hgh-29/Smart-Plant-Monitor/README.md

[README.pdf](https://github.com/user-attachments/files/24240184/README.pdf)
