hgh-29/Smart-Plant-Monitor/Presentations/Smart Plant Monitor Proof-of-Concept Prototype (1).pdf

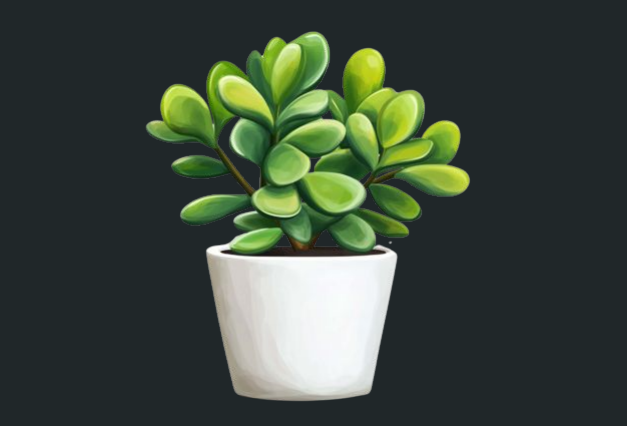
[picture p1: figure]

# Smart Plant Monitor Proof-of-Concept Prototype

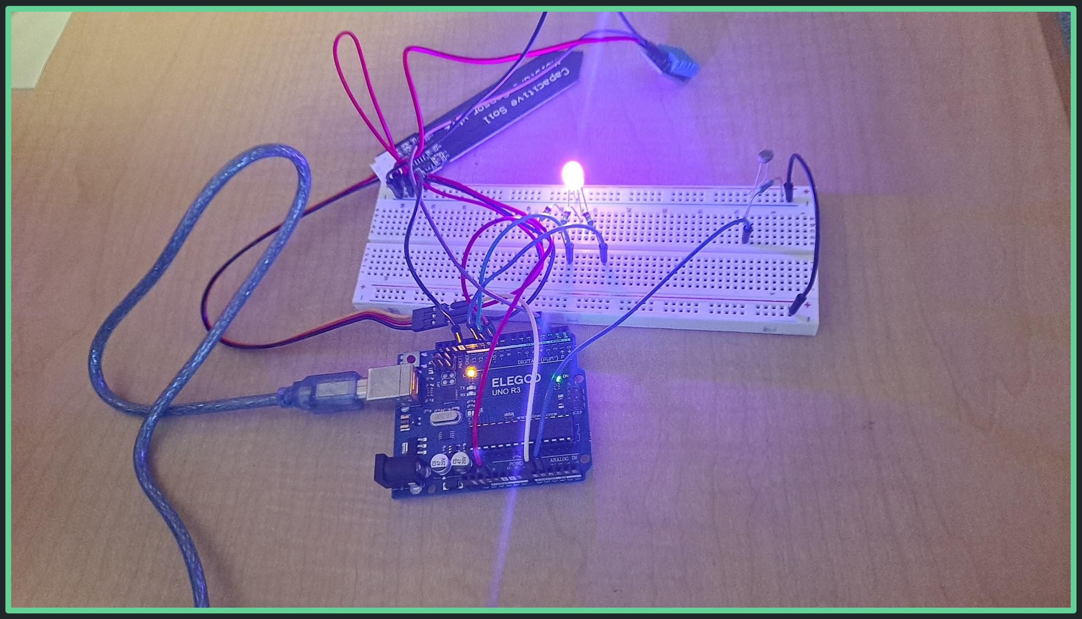
[picture p2: figure]

Rachel Romeo, Hailey Horvath, Adrian Szurlej ECET 230
10/21/2025

## The Smart Plant Monitor

What our project is supposed to do when complete

- The Smart Plant Monitor will be a simple, portable device that aims to monitor temperature, soil moisture and sunlight levels to keep plants healthy.
- The sensors will collect environmental data and give the user continuous feedback through the use of an RGB LED.
- The use of the project will make it easier to take care of plants.

## The Smart Plant Monitor

Proof-of-Concept Prototype:

- Our project is able to measure and read the current temperature, soil moisture level and light level.
- Working Components:
- Soil Moisture Sensor
- Photoresistor
- DHT11 Temperature Sensor
- RGB LED
- Serial Input (to set optimal ranges)

## The Smart Plant Monitor

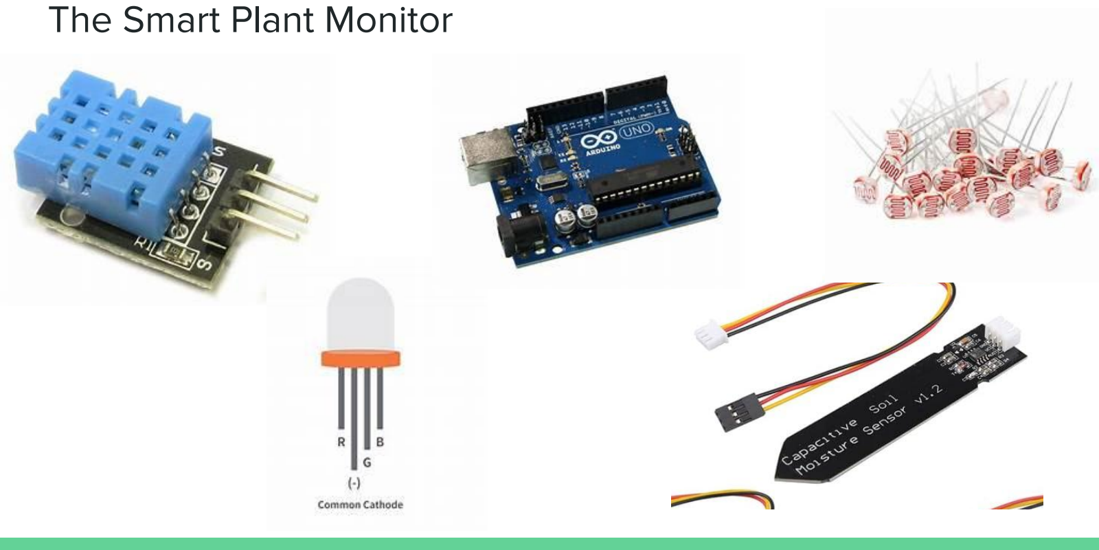
[picture p3: page 4]

## The Smart Plant Monitor

How it works:

- User is prompted to enter the optimal ranges for temperature and the minimum level for the soil moisture and light level
- Note: These are entered through the serial monitor since the input device isn’t set up yet

## The Smart Plant Monitor

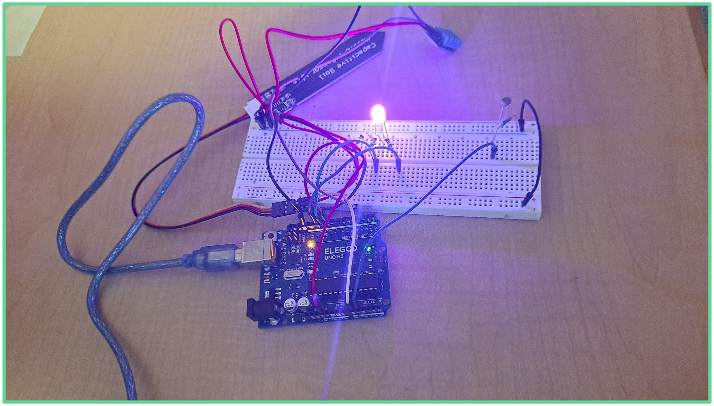
[picture p4: figure]

How it works:

- Sensors measures and reads the temperature, soil moisture and light level every 10 seconds.
- Note: 10 seconds can be changed to any duration of time
- Based on the user’s optimal ranges that were entered, the system determines whether or not if the current measurements fit into the ranges

## The Smart Plant Monitor

How it works:

Everything is in Optimal Range | RGB LED is off
Current Temperature is too hot | RGB LED turns red
Current Temperature is too cold | RGB LED turns blue
Current Soil Moisture is too dry | RGB LED turns yellow
Current Light Level is too dark | RGB LED turns purple

## The Smart Plant Monitor

How it works:

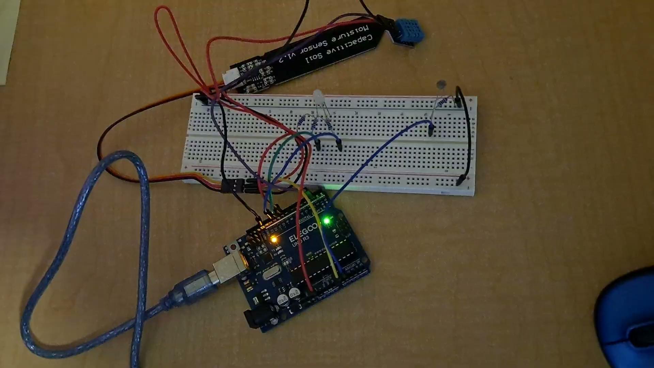
[picture p5: figure]

- If there is more than one measurement that is out of the optimal range, the RGB LED will instead blink in sequence.
- For example if the current temperature is too cold, the soil is too dry and it is too dark, the RGB LED will blink Blue, Yellow, Purple

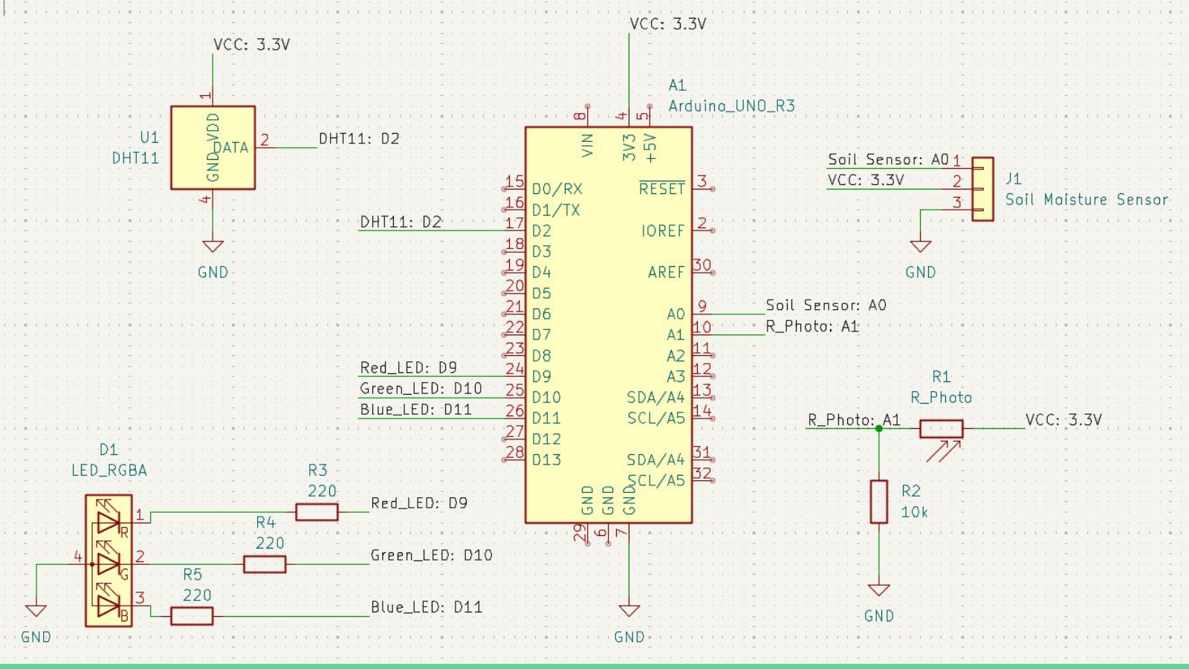
[picture p6: page 9]

## The Smart Plant Monitor

What still needs to be worked on:

- User Input Component
- Remote Control/IR Receiver
- Originally wanted to use rotary encoder
- Clock for Photoresistor
- To prevent the photoresistor from detecting low light during nighttime, a clock feature can be added to the code. This would allow the user to define specific night hours, ensuring the photoresistor is inactive during that period.
- Resistor Values
- To balance the brightness of the different colors in the RGB LED, each color should have a specific resistor value
- Display
- LCD1602
- Can be used to help guide the user when entering the optimal ranges
- Reset Button
- Used to reset the optimal ranges entered at the beginning

# Live Demo of the Proof-of-Concept Prototype

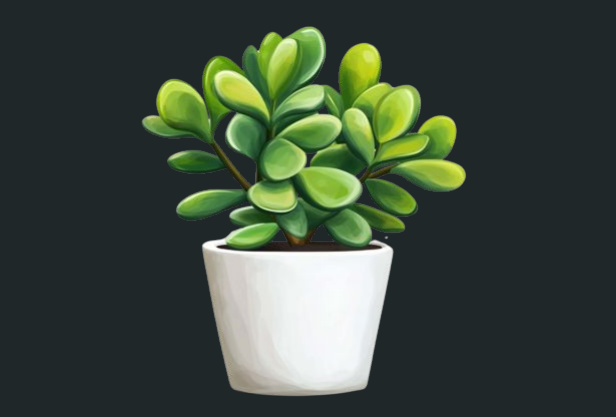
[picture p7: figure]

## Any Questions??
