hgh-29/Smart-Plant-Monitor/Presentations/Smart Plant Monitor_ ECET 230 Final Project.pdf

ECET 230-001
Professor Hansis

# Smart Plant

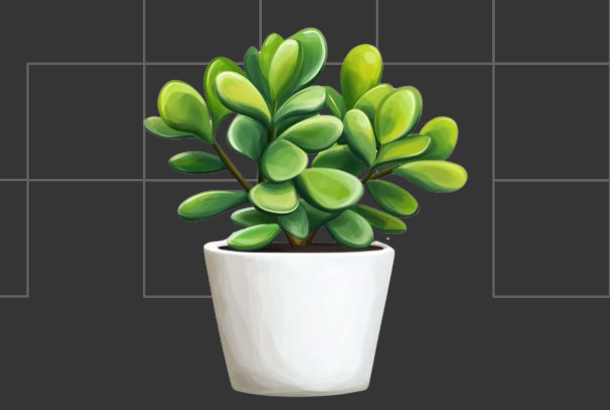
[picture p9: figure]

# Monitor

Rachel Romeo
Hailey Horvath
12/19/25

# Smart Plant Monitor Overview

# What is the Smart Plant Monitor? - The Smart Plant Monitor will be a simple, portable device that aims to monitor temperature, soil

moisture and sunlight levels to keep plants healthy.

# - The sensors will collect environmental data and

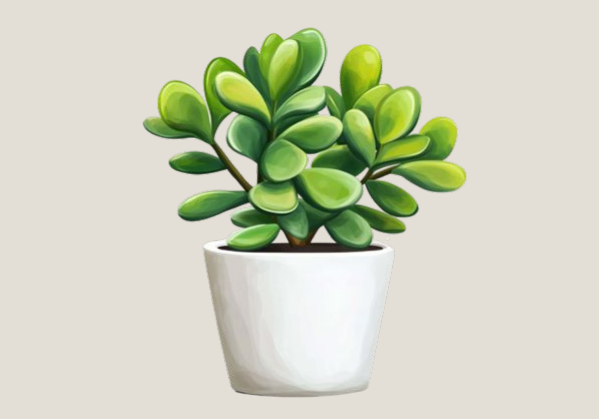
[picture p10: figure]

# give the user continuous feedback through the use

of an RGB LED.

# - The use of the project will make it easier to take

care of plants.

# Block Diagram

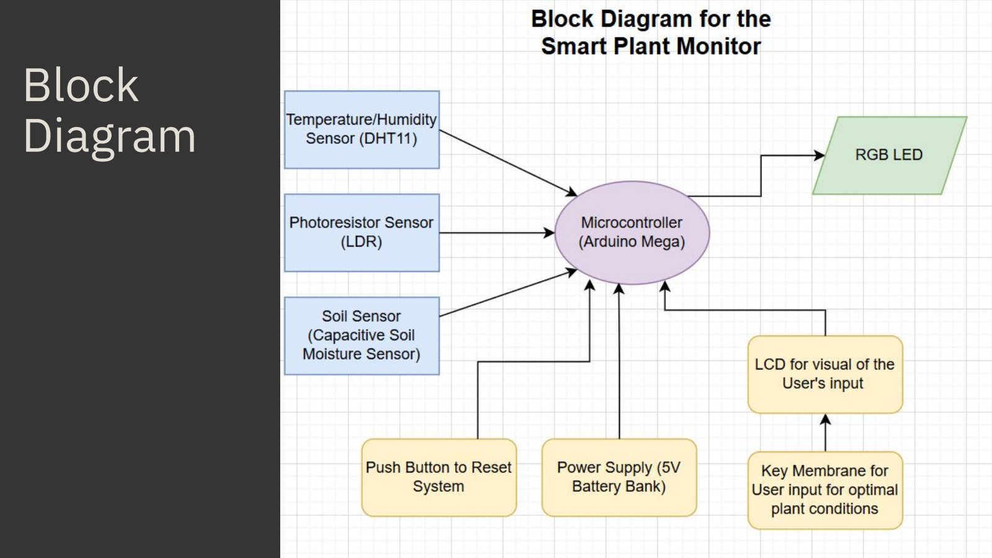
[picture p11: page 3]

# Development Process

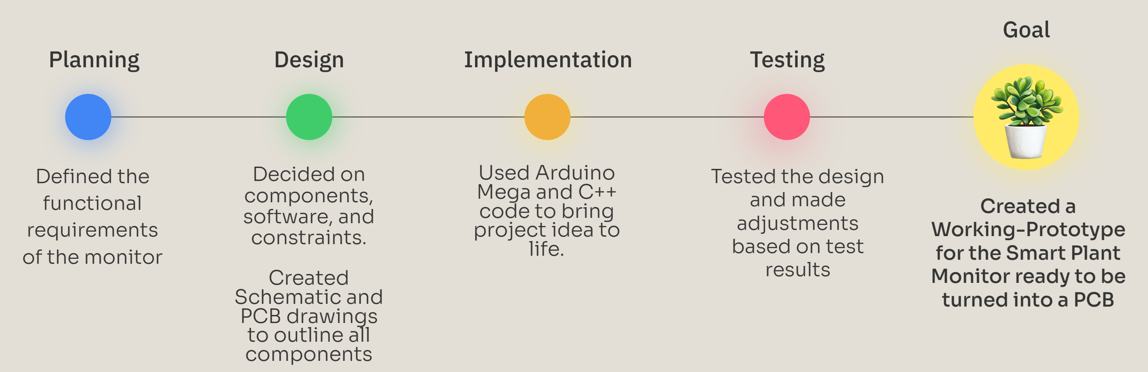
[picture p12: figure]
Planning; Design; Implementation; Testing; Goal; Defined the functional requirements of the monitor; Used Arduino Mega and C++ code to bring project idea to life.; Tested the design and made adjustments based on test results; Decided on components, software, and constraints.; Created Schematic and PCB drawings to outline all components; Created a Working-Prototype for the Smart Plant Monitor ready to be turned into a PCB

# Planning

# Key Functions:

# - Continuous Monitoring - Soil, Temperature, Sunlight - Plant Status Feedback - RGB LED - Low-Maintenance Operation - Battery Bank - Portable - Small, no larger than a phone

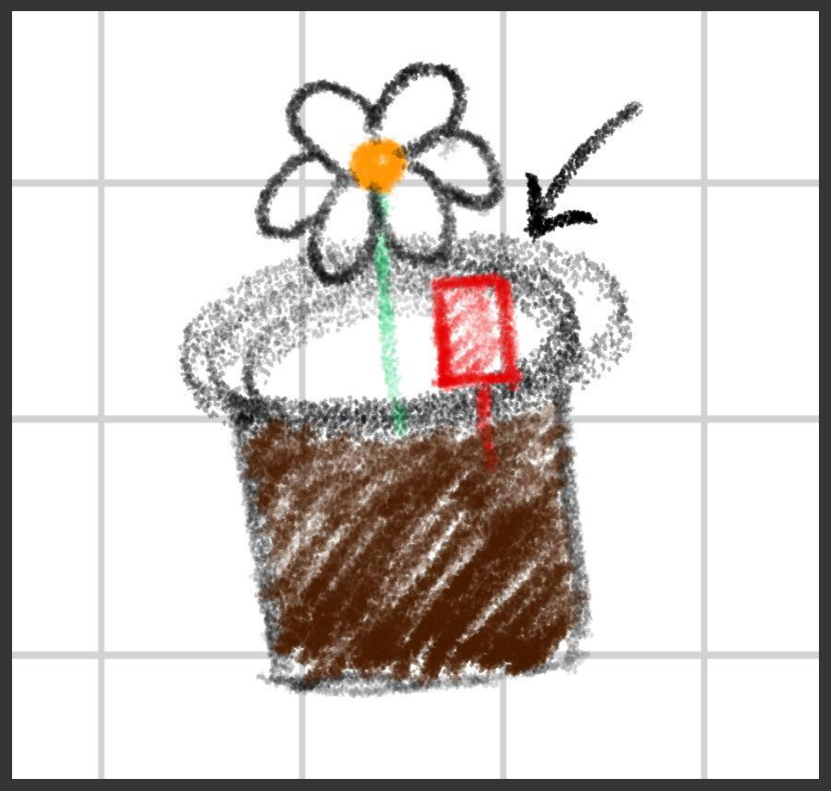
[picture p13: figure]

# Planning

Everything is in Optimal Range | RGB LED is off
Current Temperature is too hot | RGB LED turns red
Current Temperature is too cold | RGB LED turns blue
Current Soil Moisture is too dry | RGB LED turns yellow
Current Light Level is too dark | RGB LED turns purple

# - How the RGB LED works:

# Hardware Design

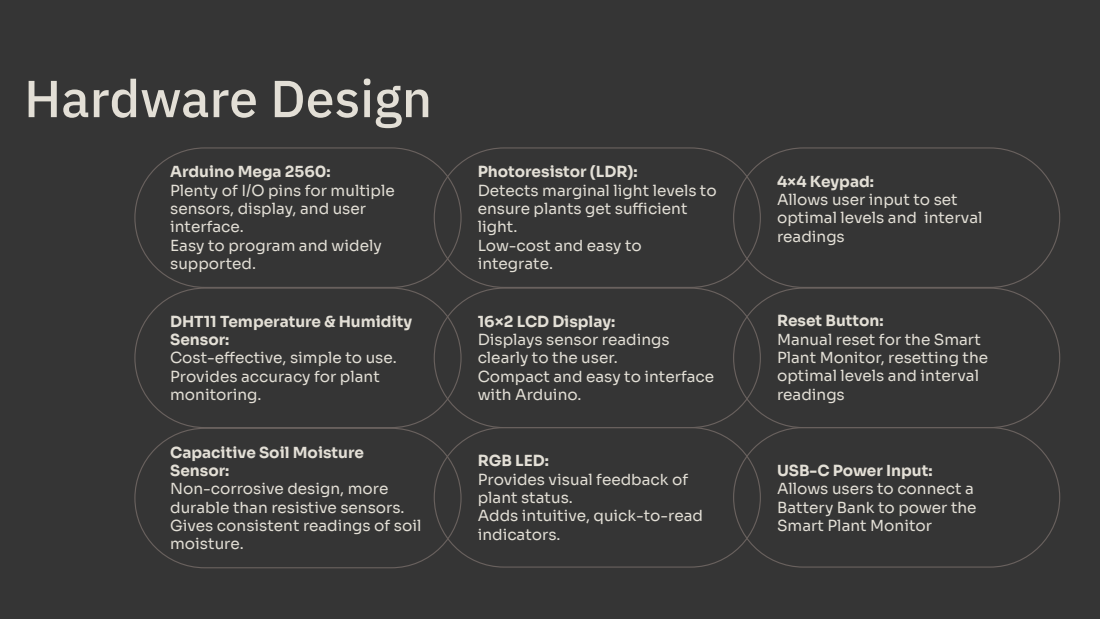
[picture p14: page 7]

Arduino Mega 2560:
Plenty of I/O pins for multiple
sensors, display, and user
interface.
Easy to program and widely
supported.

Photoresistor (LDR):
Detects marginal light levels to
ensure plants get sufficient
light.
Low-cost and easy to
integrate.

4×4 Keypad:
Allows user input to set
optimal levels and interval
readings

Reset Button:
Manual reset for the Smart
Plant Monitor, resetting the

DHT11 Temperature & Humidity
Sensor:
Cost-effective, simple to use.
Provides accuracy for plant
monitoring.

16×2 LCD Display:
Displays sensor readings
clearly to the user.
Compact and easy to interface
with Arduino.

Capacitive Soil Moisture
Non-corrosive design, more
durable than resistive sensors.
Gives consistent readings of soil
moisture.

RGB LED:
Provides visual feedback of
plant status.
Adds intuitive, quick-to-read
indicators.

USB-C Power Input:
Allows users to connect a
Battery Bank to power the
Smart Plant Monitor

# Hardware Design

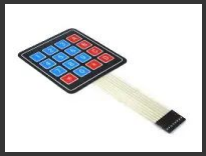
[picture p15: figure]
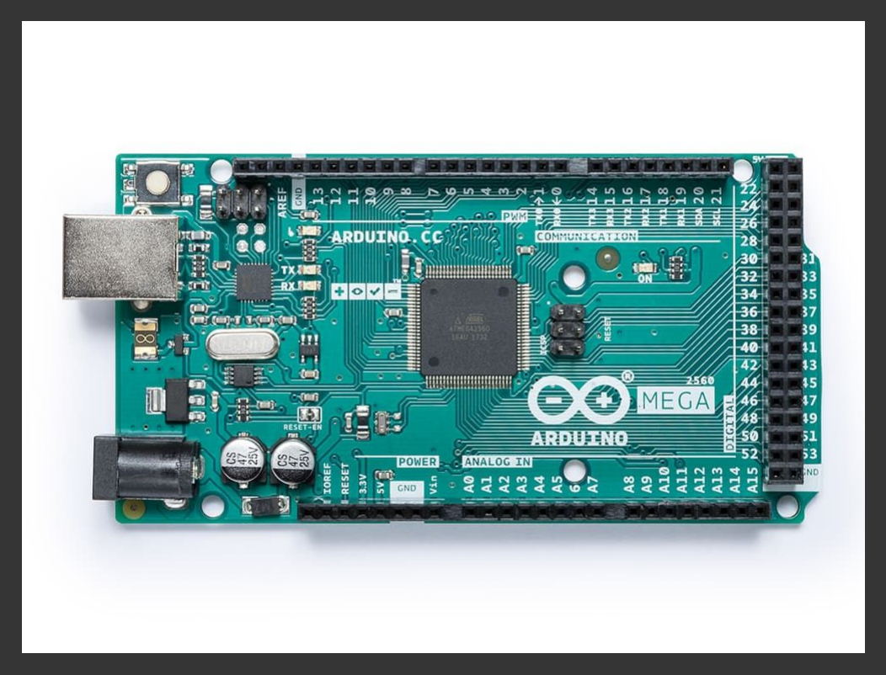
[picture p16: figure]
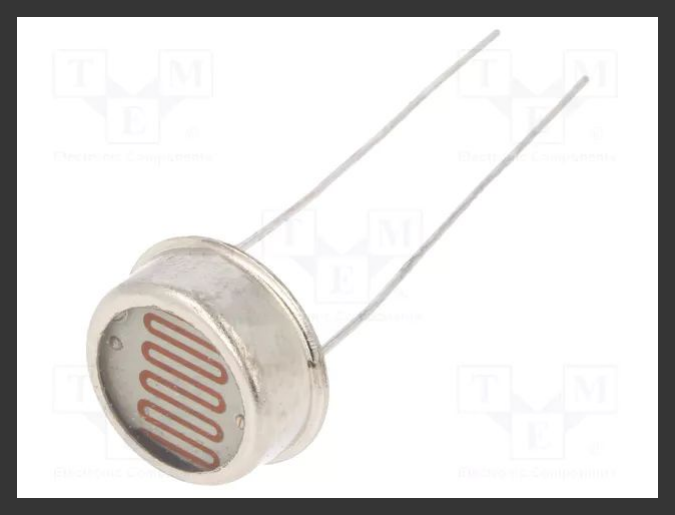
[picture p17: figure]

Arduino Mega 2560

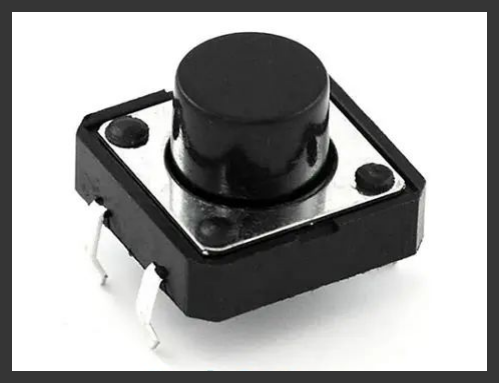
[picture p18: figure]
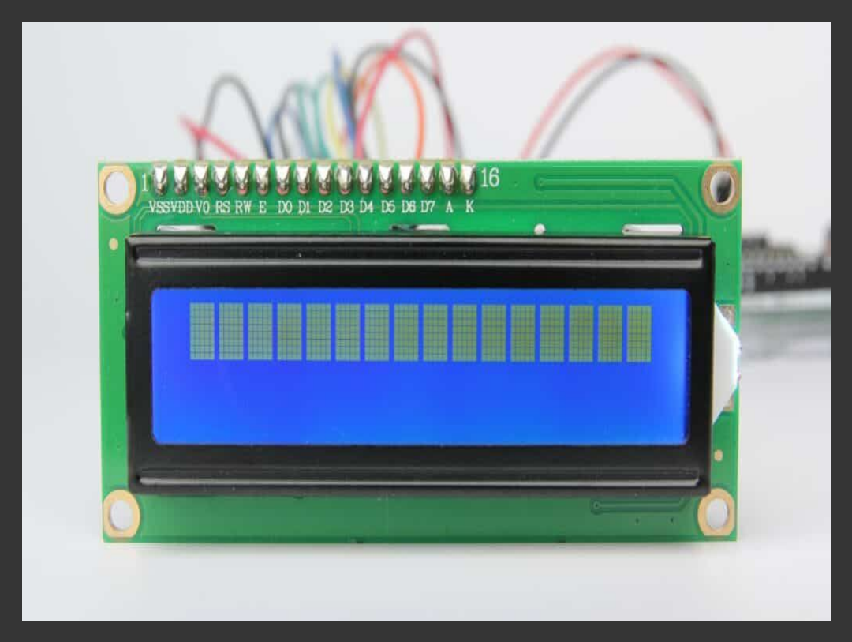
[picture p19: figure]
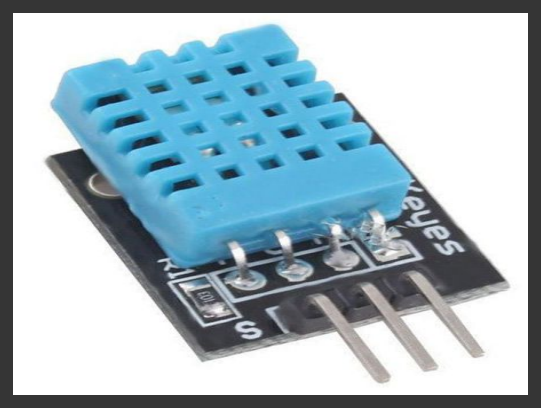
[picture p20: figure]

DHT11

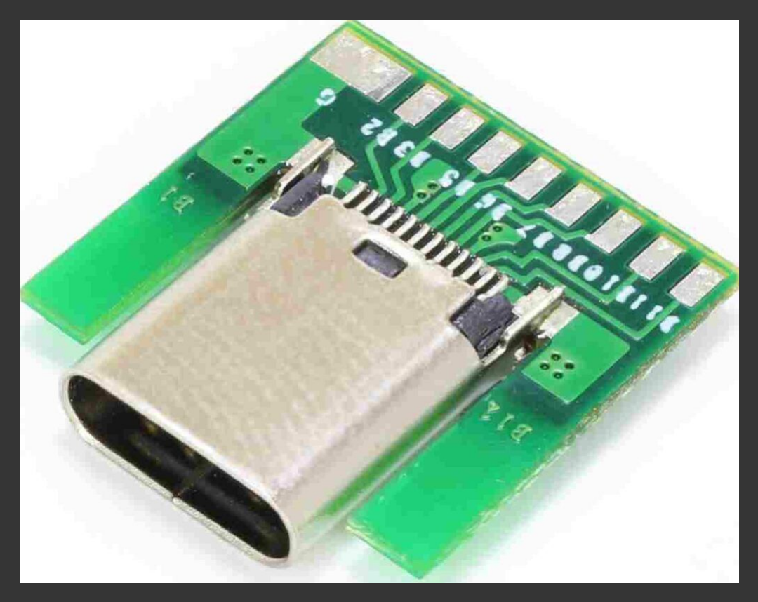
[picture p21: figure]
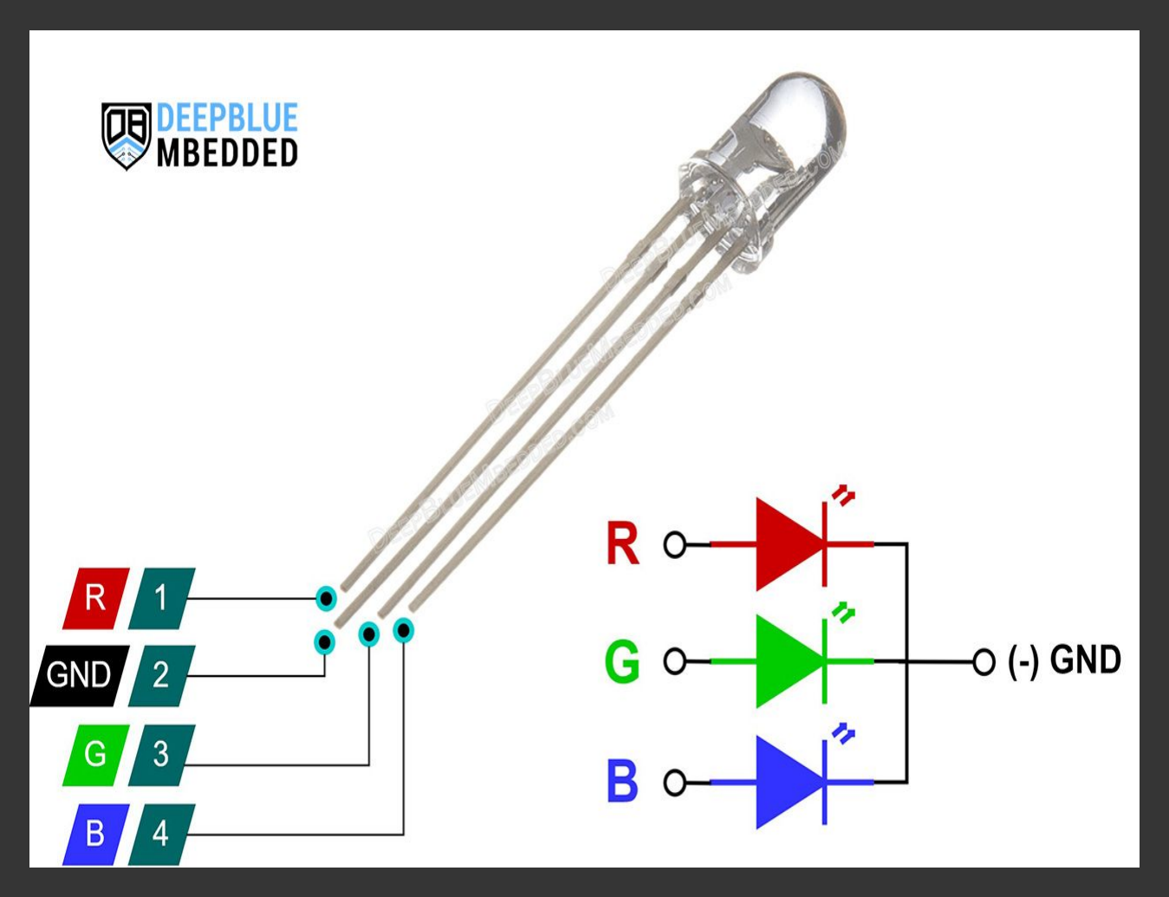
[picture p22: figure]
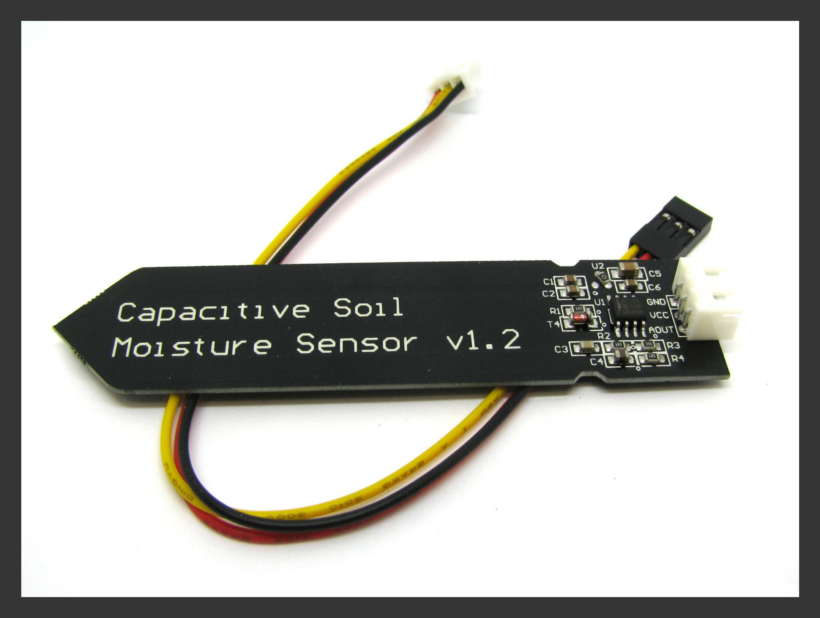
[picture p23: figure]

Soil Moisture Sensor

Photoresistor

LCD Display

RGB LED

Keypad

Push Button

USB-C Input

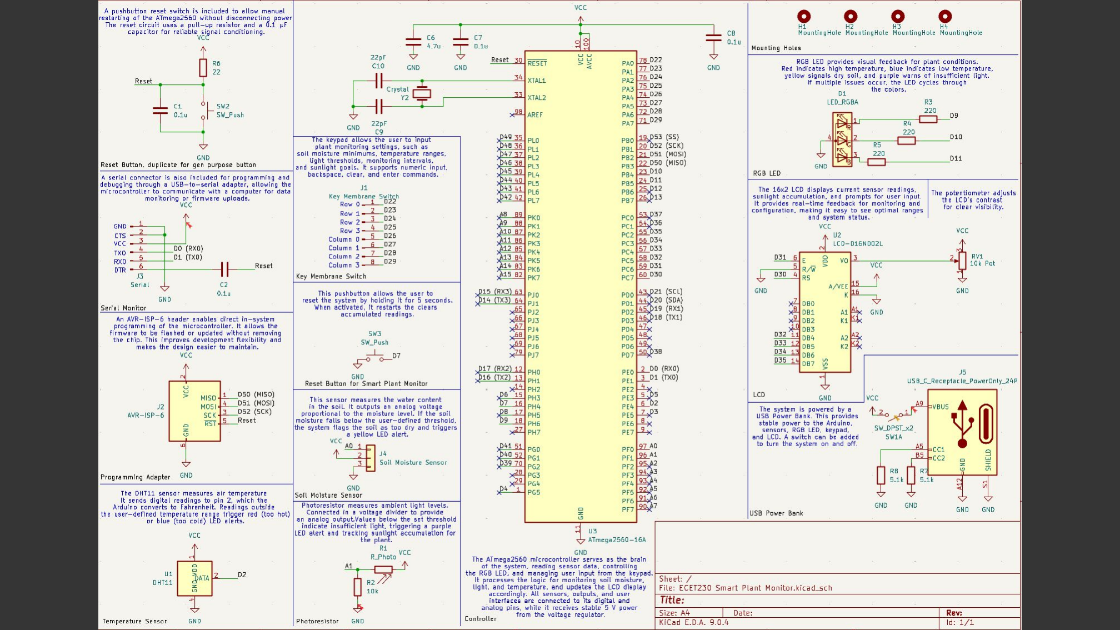
[picture p24: page 9]

# PCB Design

# - Dimensions: - Height: 142mm → 5.59 inches - Width: 182mm → 7.16 inches - Weight: 50-300 grams

# - Power Management: - Powered by a Battery Bank ( about 100 hours before charging is needed)

# - Component Placement: - Spaced out to increase reliability - GND Copper Fill to reduce noise and tracks

# PCB Layout

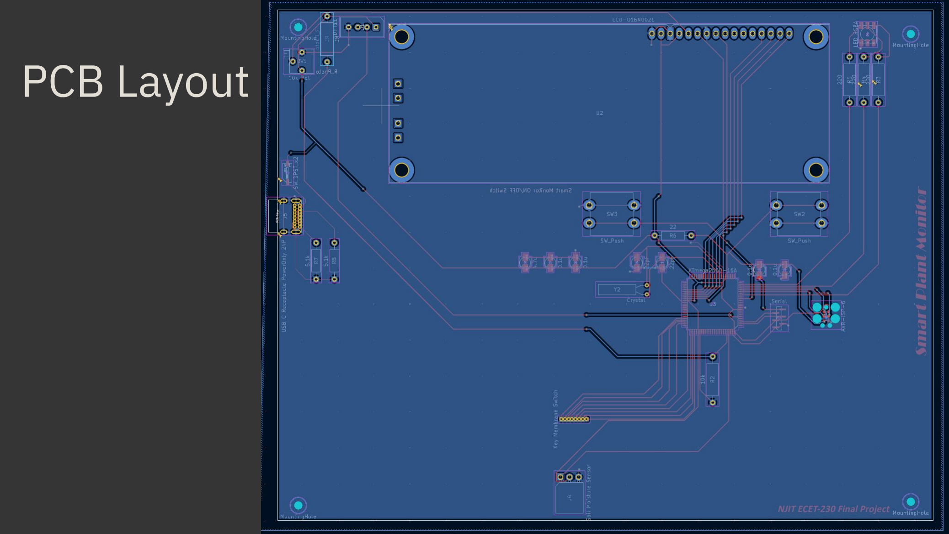
[picture p25: page 11]

# 3D Rendering

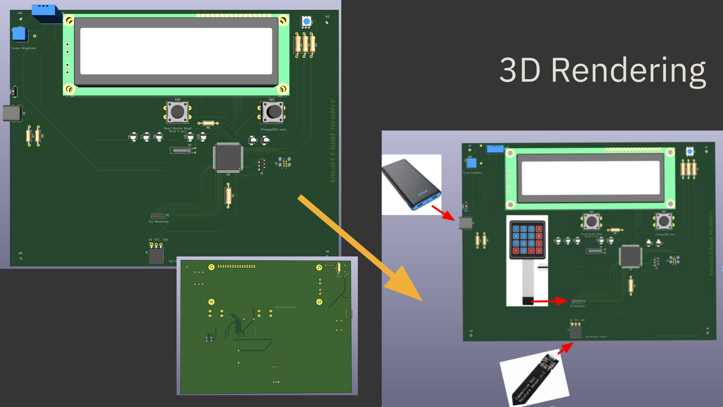
[picture p26: page 12]

# Implementation

# - Operation Modes: - Real Mode and Test Mode - Measurement Intervals - User defined using key membrane - How the Monitor Detects “Nighttime” - Nighttime is determined in the code when light levels remain

below 50 for a continuous period.

# ■ Test mode: 60 consecutive seconds ■ Real mode: 2 consecutive hours

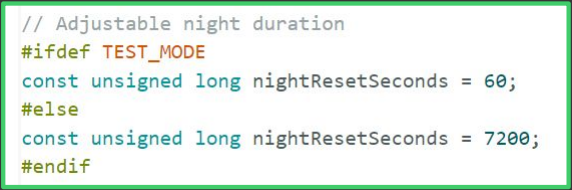
[picture p27: figure]

# Implementation

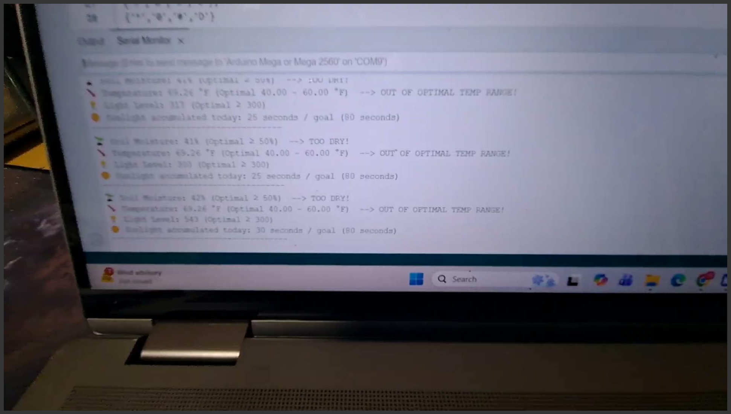
[picture p28: figure]

# Testing

# - Before implementing each component in the

design was first tested with its own code.

# - This allowed troubleshooting, figuring out

which components work and which ones didn’t.

# - Testing the full code revealed potential issues each time: - What if I input the wrong number into the key membrane? - What if the number I imputed as the higher temperature bound is actually lower than the lower temperature bound?

# Testing

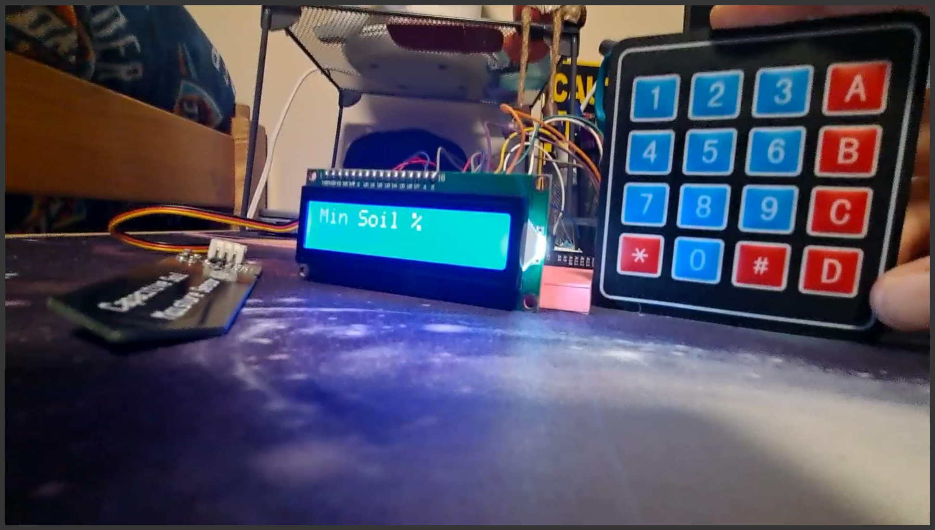
[picture p29: figure]

# Functionality of the Product

## ✔ Requirements Met

- Continuous monitoring: soil moisture, temperature, humidity,

## light, and daily sunlight - RGB LED provides plant status feedback (colors + flashing sequence) - Low-maintenance operation: 5V battery bank (~100 hours) - LCD display shows sensor readings - Keypad allows user to set thresholds - Test mode works for safe simulation

## ✖ Requirements Not Met

## - Prototype size slightly wider than planned - Battery runtime falls short of 1-week goal - Solar panel integration not implemented

# Challenges & Solutions

Issues | Solutions
IR sensor and Remote Not Working | Tried for a few weeks but then the decision was made to switch components

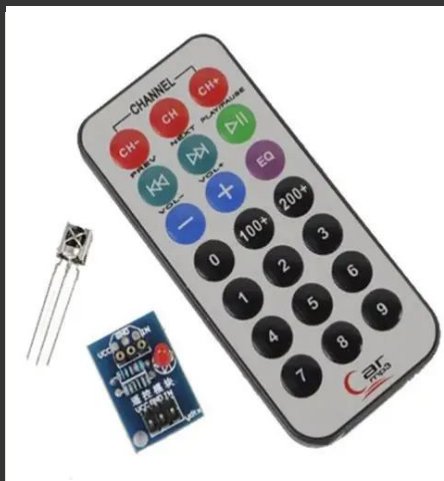
[picture p30: figure]

Reset Button not working on Keypad | Added separate push button for reset button.
9V battery would only last 1-2 hours | Switched to a battery bank which increased runtime
Length of night is built into the code, users can not set how long night is. | After research and time constraints, it was better to hardcode a nighttime mode

### Solar Power Integration

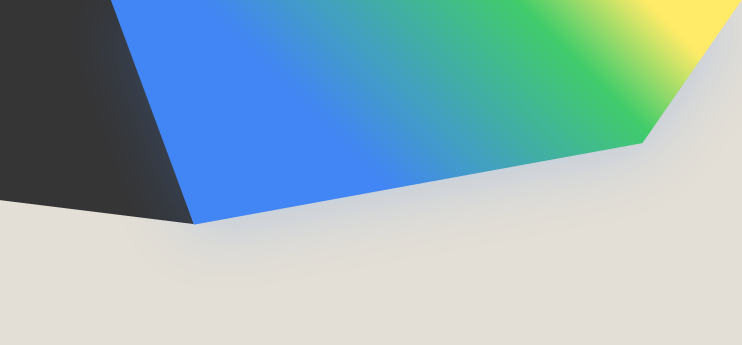
[picture p31: figure]

## A solar panel battery would store energy for the moments where there is no sunlight available (nighttime or cloudy days). A self sustainable product limits user interaction, improving the

convenience of our product and making it more user friendly.

### Waterproof / Weather-Resistant Housing

## An enclosure would limit the risk of physical damage done to the product as well as issues such as overheating, corrosion, or weather damage. Having a PCB in an enclosure also improves the reliability

of the PCB by reducing any interference from EMI and RFI.

### Wireless Data Transmission

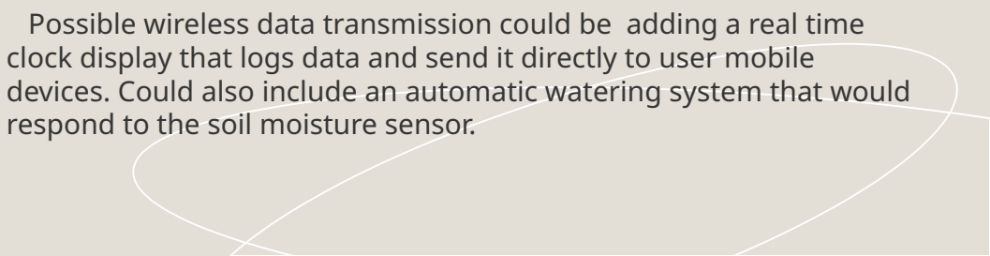
[picture p32: figure]
respond to the soil moisture sensor.

## Possible wireless data transmission could be adding a real time clock display that logs data and send it directly to user mobile devices. Could also include an automatic watering system that would

# Future Steps

# Lessons Learned

## - The importance of reading data sheets for component

selection.

## - The importance of test codes before implementing

components.
- We were able to grow our knowledge of C++.
- The benefits of a Power Budget.

## - Group work requires a lot of communication and dedication

from all members.

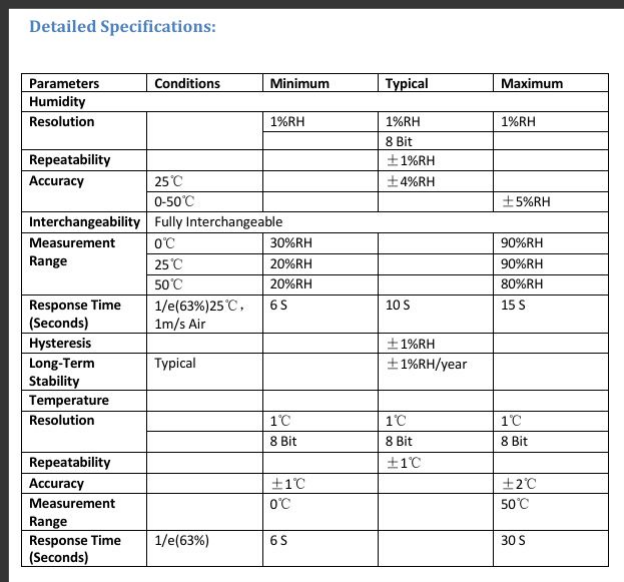
[picture p33: figure]

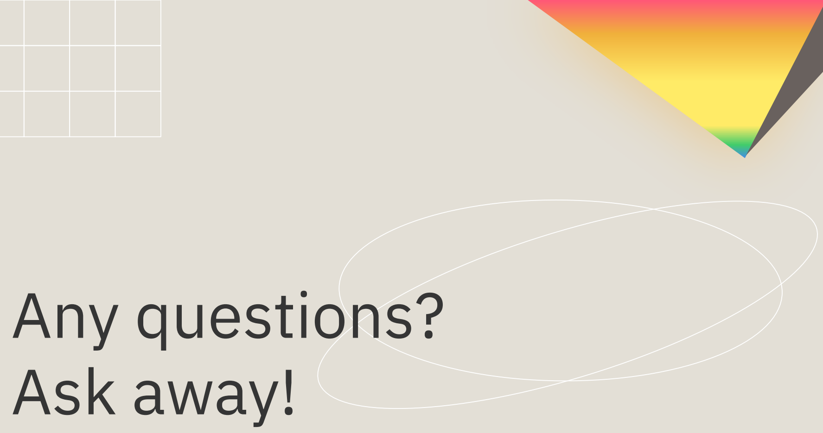
[picture p34: figure]
Any questions? Ask away!

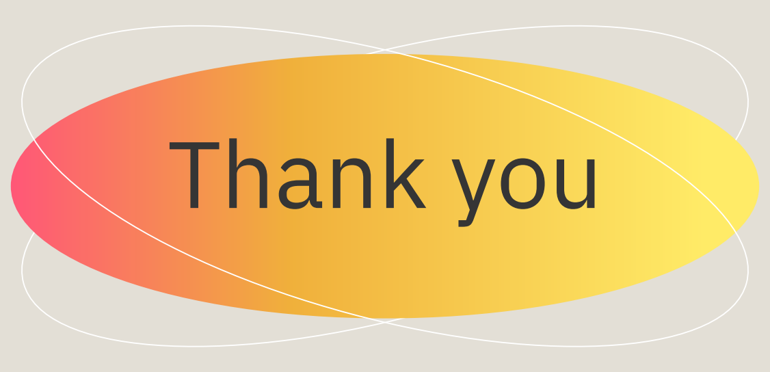
[picture p35: figure]
Thank you
