hgh-29/Smart-Plant-Monitor/KiCad/Fabrication Files/Ordering instructions.pdf

## ECET 230 - Ordering instructions

### Rachel Romeo, Hailey Horvath

2025-12-20

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
### 1. P

C

B

S

p

e

cifi

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
### 2. P

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
## PCB Specification Selection

- Board type: Single pieces
- Single pieces are ideal for prototypes or small runs. This allows faster turnaround and reduces costs compared to a panelized order.
- Different design in panel: 1
- There is only 1 PCB design being ordered
- Size: 182mm by 142mm
- Quantity: 5 pcs
- A small batch is sufficient for testing and debugging.
- Layers: 2 Layers
- The design of the PCB calls for 2 layers
- Material: FR-4
- FR-4 is the standard PCB material, offering good mechanical stability, thermal resistance, and electrical insulation
- FR4-TG: TG 150-160
- TG 150-160 gives a slightly higher glass transition temperature than the base FR-4, improving thermal stability during soldering and operation.
- Thickness: 1.6mm
- 1.6 mm is the standard PCB thickness, providing good rigidity and compatibility with most enclosures and mounting hardware.
- Min track/spacing: 6/6mil
- 6/6mil meets the minimum design requirement of 0.15 mm for both track width and spacing, ensuring manufacturability while maintaining a safe margin above the limit.
- Min hole size: 0.3mm
- Solder mask: Green
- Silkscreen: Black
- Black silkscreen is highly visible on a green mask, making component labels and markings easy to read.
- UV printing Multi-color: None
- Edge connector: No
- Surface finish: HASL with lead
- HASL with lead is reliable, inexpensive, and compatible with through-hole and SMT components.
- Via process: Tenting vias
- Finish copper: 1 oz Cu
- 1 oz copper is standard, balancing current-carrying capacity and cost.

## PCB Way Order

The following website was used to generate the ordering Instructions: https://www.pcbway.com/orderonline.aspx

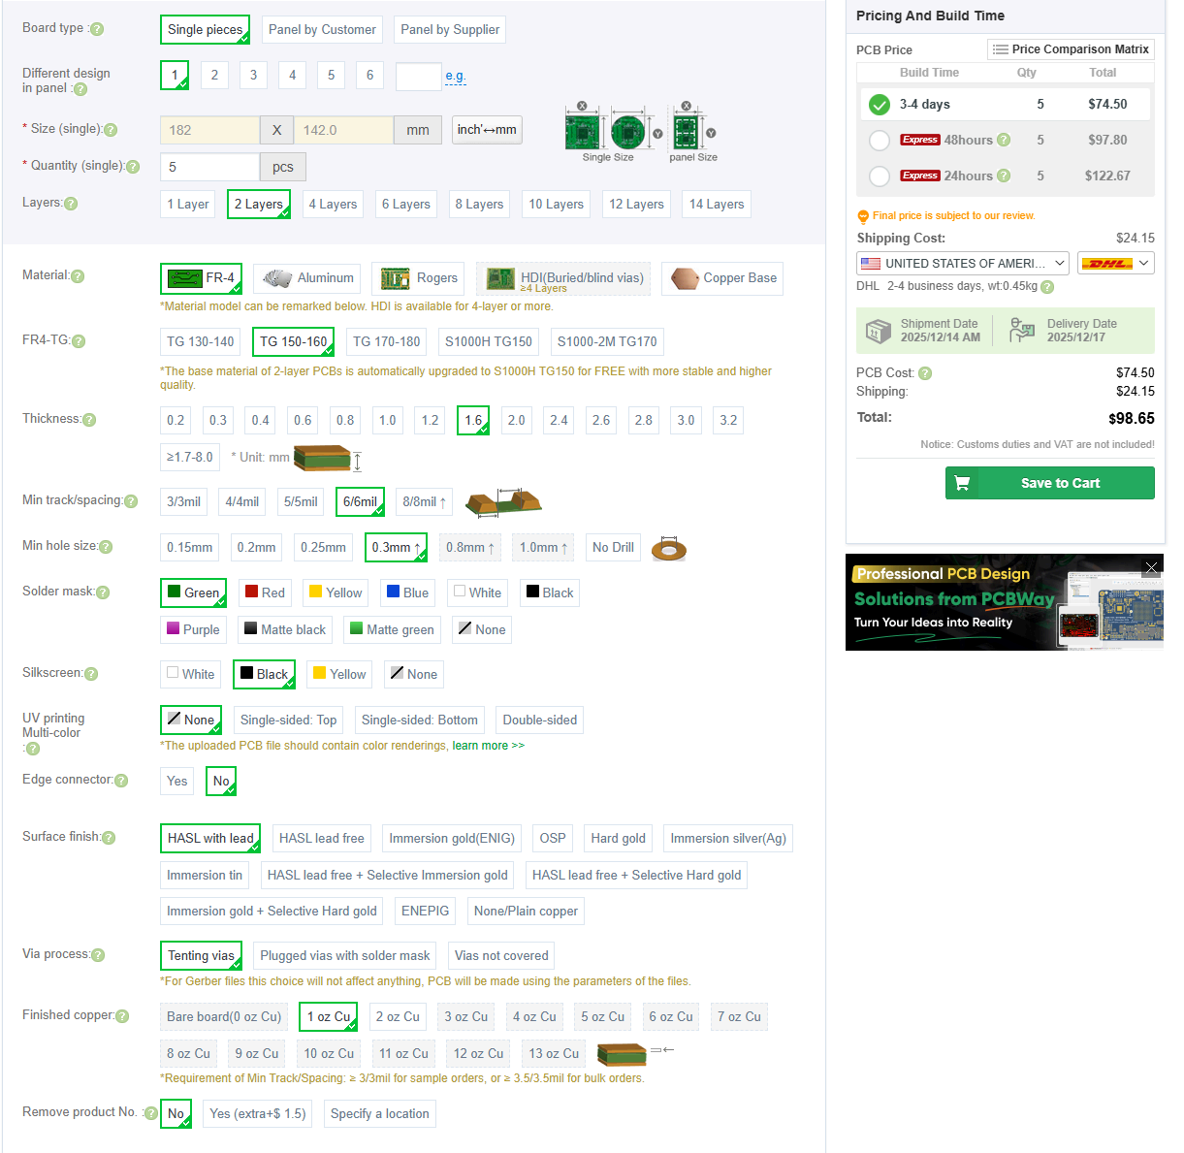
[picture p44: figure]
