hgh-29/Smart-Plant-Monitor/KiCad/KiCad Project/ECET230 Smart Plant Monitor.kicad_pcb

## KiCad design KiCad/KiCad Project/ECET230 Smart Plant Monitor.kicad_pcb (2025-12-18)

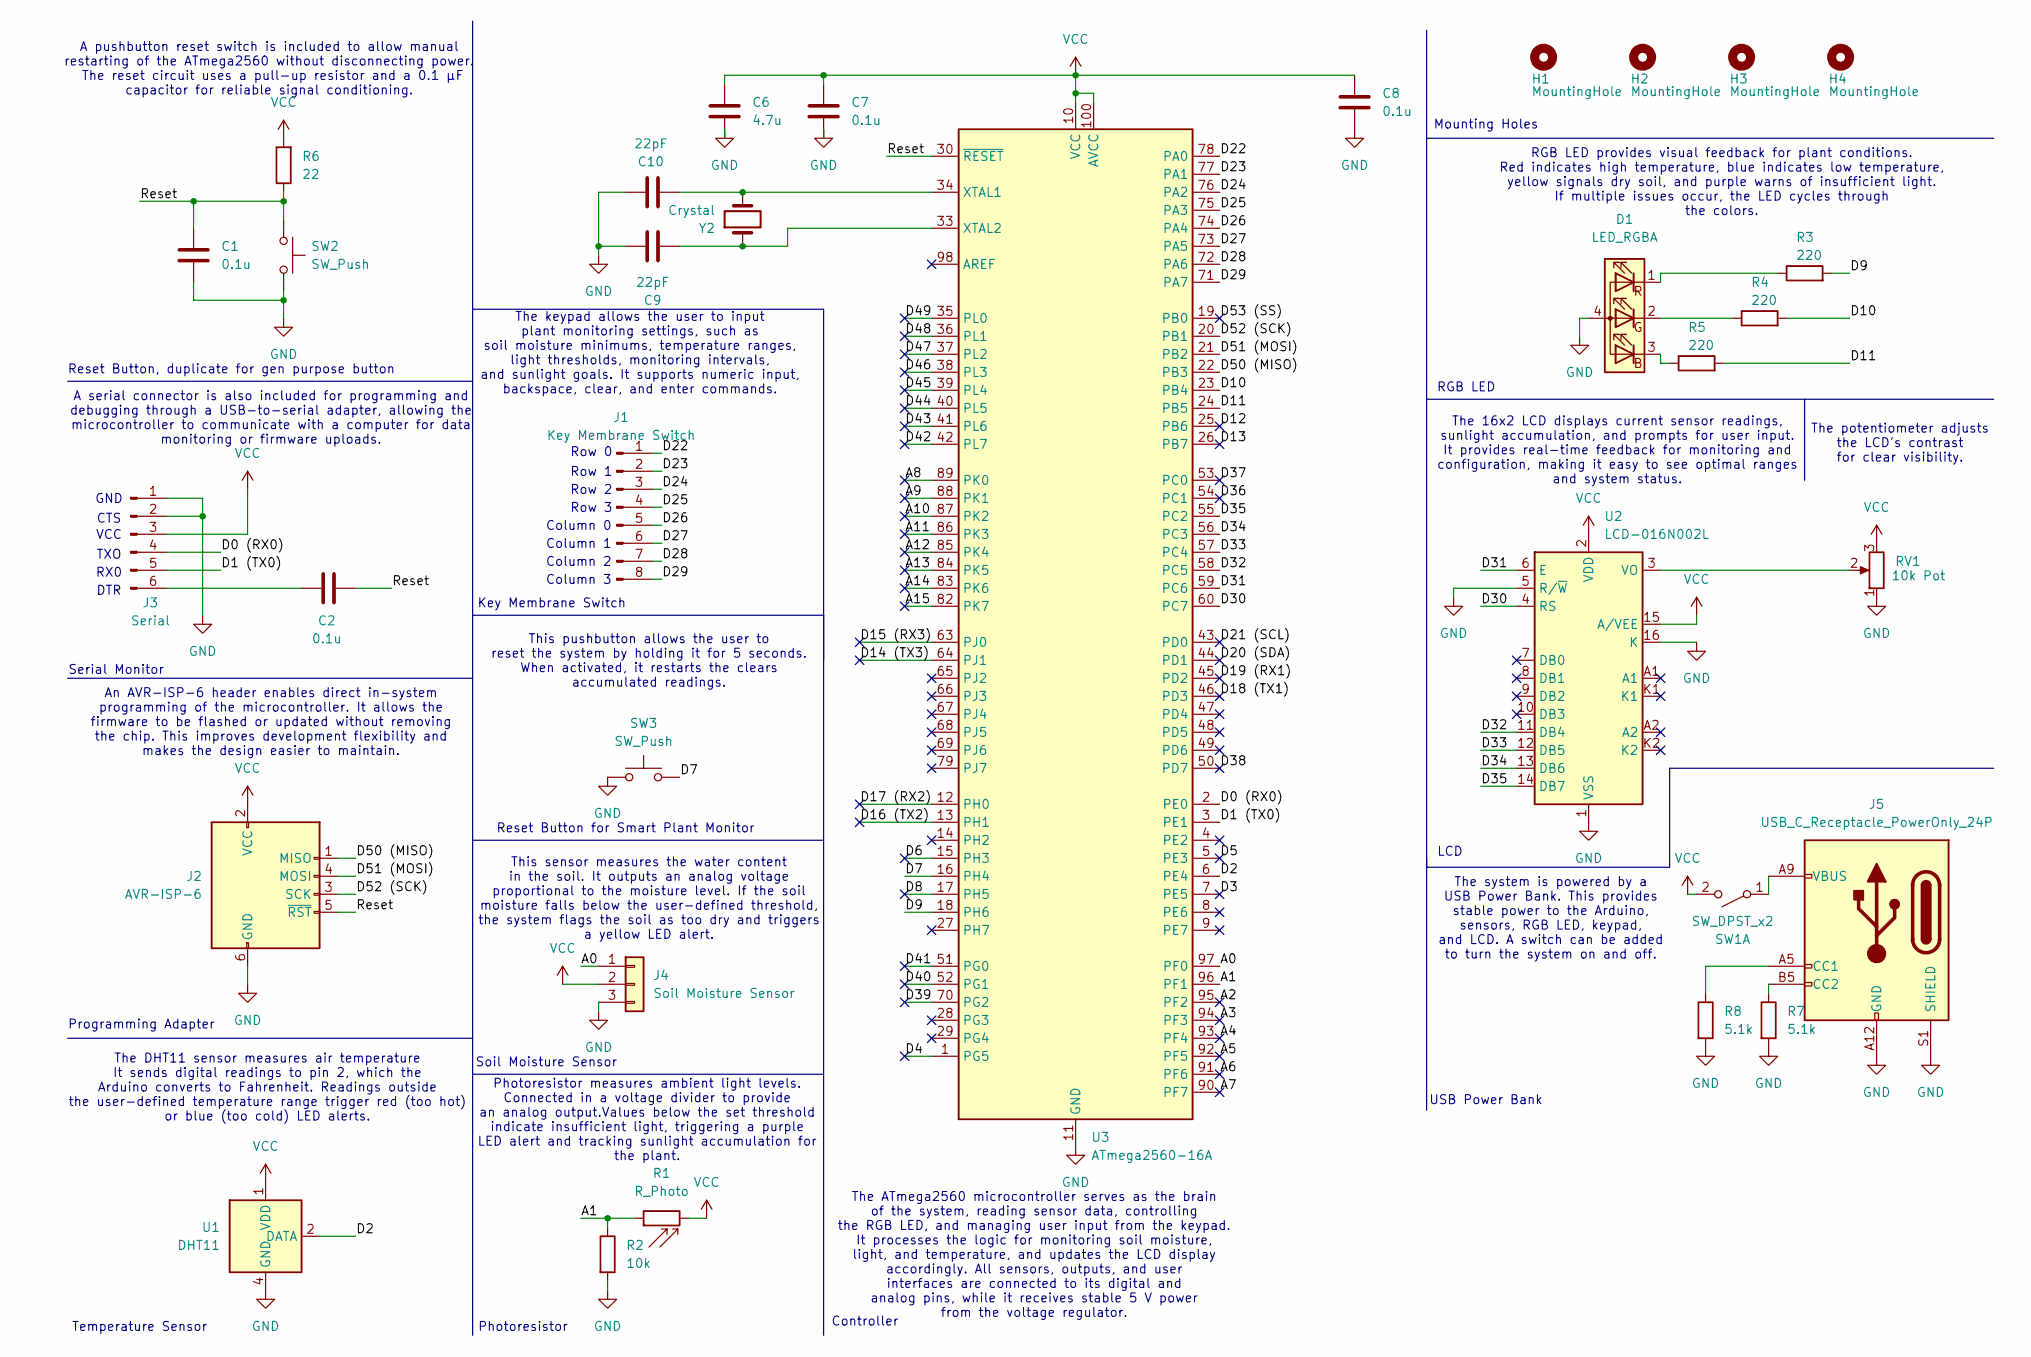
[picture p46: schematic ECET230 Smart Plant Monitor.kicad_sch]

Parts:
C1, C2, C7, C8: 0.1u; CP_Elec_3x5.3; MPN GRM033C71C104KE14D
C6: 4.7u; CP_Elec_3x5.3; MPN GRM035R60J475ME15D
C9, C10: 22pF; CP_Elec_3x5.3; MPN C0603C220J5GACTU
D1: LED_RGBA; LED_RGB_5050-6; MPN YSL-R596CR3G4B5C-C10
H1, H2, H3, H4: MountingHole; MountingHole_2.1mm
J1: Key Membrane Switch; PinHeader_1x08_P1.00mm_Vertical; MPN PPTC081LFBN-RC
J2: AVR-ISP-6; Tag-Connect_TC2030-IDC-FP_2x03_P1.27mm_Vertical; MPN SFH11-NBPC-D03-ST-BK
J3: Serial; PinSocket_1x06_P1.00mm_Vertical_SMD_Pin1Right; MPN OSTOQ063250
J4: Soil Moisture Sensor; PinSocket_1x03_P2.54mm_Horizontal; MPN PPPC031LGBN-RC
J5: USB_C_Receptacle_PowerOnly_24P; USB_C_Receptacle_GCT_USB4085; MPN USB4125-GF-A
R1: R_Photo; R_Axial_DIN0309_L9.0mm_D3.2mm_P12.70mm_Horizontal; MPN PDV-P8103
R2: 10k; R_Axial_DIN0309_L9.0mm_D3.2mm_P12.70mm_Horizontal; MPN CF14JT10K0
R3, R4, R5: 220; R_Axial_DIN0309_L9.0mm_D3.2mm_P12.70mm_Horizontal; MPN CF14JT220R
R6: 22; R_Axial_DIN0207_L6.3mm_D2.5mm_P10.16mm_Horizontal; MPN CF14JT22R0
R7, R8: 5.1k; R_Axial_DIN0207_L6.3mm_D2.5mm_P10.16mm_Horizontal; MPN CF14JT5K10
RV1: 10k Pot; Potentiometer_Bourns_3266P_Horizontal; MPN PV36W103C01B00
SW1: SW_DPST_x2; SW_DIP_SPSTx01_Slide_Copal_CHS-01A_W5.08mm_P1.27mm_JPin; MPN JS202011CQN
SW2, SW3: SW_Push; SW_PUSH-12mm_Wuerth-430476085716; MPN Y41A00521FPLFS
U1: DHT11; Aosong_DHT11_5.5x12.0_P2.54mm; MPN 386
U2: LCD-016N002L; MPN HD44780U (LCD-II)
U3: ATmega2560-16A; TQFP-100_14x14mm_P0.5mm; MPN ATMEGA2560-16AU
Y2: Crystal; Crystal_AT310_D3.0mm_L10.0mm_Horizontal; MPN ABS07-32.768KHZ-T

Connections:
/A0: J4.1, U3.97 (PF0)
/A1: R1.1, R2.1, U3.96 (PF1)
/A2: U3.95 (PF2)
/A3: U3.94 (PF3)
/A4: U3.93 (PF4)
/A5: U3.92 (PF5)
/A6: U3.91 (PF6)
/A7: U3.90 (PF7)
/A8: U3.89 (PK0)
/A9: U3.88 (PK1)
/A10: U3.87 (PK2)
/A11: U3.86 (PK3)
/A12: U3.85 (PK4)
/A13: U3.84 (PK5)
/A14: U3.83 (PK6)
/A15: U3.82 (PK7)
/D0 (RX0): J3.4, U3.2 (PE0)
/D1 (TX0): J3.5, U3.3 (PE1)
/D2: U1.2 (DATA), U3.6 (PE4)
/D3: U3.7 (PE5)
/D4: U3.1 (PG5)
/D5: U3.5 (PE3)
/D6: U3.15 (PH3)
/D7: SW3.2, U3.16 (PH4)
/D8: U3.17 (PH5)
/D9: R3.2, U3.18 (PH6)
/D10: R4.2, U3.23 (PB4)
/D11: R5.2, U3.24 (PB5)
/D12: U3.25 (PB6)
/D13: U3.26 (PB7)
/D14 (TX3): U3.64 (PJ1)
/D15 (RX3): U3.63 (PJ0)
/D16 (TX2): U3.13 (PH1)
/D17 (RX2): U3.12 (PH0)
/D18 (TX1): U3.46 (PD3)
/D19 (RX1): U3.45 (PD2)
/D20 (SDA): U3.44 (PD1)
/D21 (SCL): U3.43 (PD0)
/D22: J1.1, U3.78 (PA0)
/D23: J1.2, U3.77 (PA1)
/D24: J1.3, U3.76 (PA2)
/D25: J1.4, U3.75 (PA3)
/D26: J1.5, U3.74 (PA4)
/D27: J1.6, U3.73 (PA5)
/D28: J1.7, U3.72 (PA6)
/D29: J1.8, U3.71 (PA7)
/D30: U2.4 (RS), U3.60 (PC7)
/D31: U2.6 (E), U3.59 (PC6)
/D32: U2.11 (DB4), U3.58 (PC5)
/D33: U2.12 (DB5), U3.57 (PC4)
/D34: U2.13 (DB6), U3.56 (PC3)
/D35: U2.14 (DB7), U3.55 (PC2)
/D36: U3.54 (PC1)
/D37: U3.53 (PC0)
/D38: U3.50 (PD7)
/D39: U3.70 (PG2)
/D40: U3.52 (PG1)
/D41: U3.51 (PG0)
/D42: U3.42 (PL7)
/D43: U3.41 (PL6)
/D44: U3.40 (PL5)
/D45: U3.39 (PL4)
/D46: U3.38 (PL3)
/D47: U3.37 (PL2)
/D48: U3.36 (PL1)
/D49: U3.35 (PL0)
/D50 (MISO): J2.1 (MISO), U3.22 (PB3)
/D51 (MOSI): J2.4 (MOSI), U3.21 (PB2)
/D52 (SCK): J2.3 (SCK), U3.20 (PB1)
/D53 (SS): U3.19 (PB0)
/Reset: C1.1, C2.1, J2.5 (~RST), R6.1, SW2.1, U3.30 (~RESET)
GND: C1.2, C6.2, C7.2, C8.2, C9.1, C10.1, D1.4 (A), J2.6 (GND), J3.1, J3.2, J4.3, J5.A1 (GND), J5.A12 (GND), J5.B1 (GND), J5.B12 (GND), J5.S1 (SHIELD), R2.2, R7.2, R8.2, RV1.1, SW2.2, SW3.1, U1.4 (GND), U2.1 (VSS), U2.5 (R/~W), U2.16 (K), U3.11 (GND), U3.32 (GND), U3.62 (GND), U3.81 (GND), U3.99 (GND)
unnamed: D1.3 (BK), R5.1
unnamed: D1.2 (GK), R4.1
unnamed: D1.1 (RK), R3.1
unnamed: C2.2, J3.6
unnamed: J5.A5 (CC1), R8.1
unnamed: J5.B5 (CC2), R7.1
unnamed: J5.A4 (VBUS), J5.A9 (VBUS), J5.B4 (VBUS), J5.B9 (VBUS), SW1.1 (A)
unnamed: RV1.2, U2.3 (VO)
unnamed: C10.2, U3.34 (XTAL1), Y2.2
unnamed: C9.2, U3.33 (XTAL2), Y2.1
VCC: C6.1, C7.1, C8.1, J2.2 (VCC), J3.3, J4.2, R1.2, R6.2, RV1.3, SW1.2 (B), U1.1 (VDD), U2.2 (VDD), U2.15 (A/VEE), U3.10 (VCC), U3.31 (VCC), U3.61 (VCC), U3.80 (VCC), U3.100 (AVCC)

Notes on the sheet:
The 16x2 LCD displays current sensor readings, sunlight accumulation, and prompts for user input. It provides real-time feedback for monitoring and configuration, making it easy to see optimal ranges and system status.
An AVR-ISP-6 header enables direct in-system programming of the microcontroller. It allows the firmware to be flashed or updated without removing the chip. This improves development flexibility and makes the design easier to maintain.
GND
Programming Adapter
LCD
RGB LED provides visual feedback for plant conditions. Red indicates high temperature, blue indicates low temperature, yellow signals dry soil, and purple warns of insufficient light. If multiple issues occur, the LED cycles through the colors.
Serial Monitor
The ATmega2560 microcontroller serves as the brain of the system, reading sensor data, controlling the RGB LED, and managing user input from the keypad. It processes the logic for monitoring soil moisture, light, and temperature, and updates the LCD display accordingly. All sensors, outputs, and us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
A pushbutton reset switch is included to allow manual restarting of the ATmega2560 without disconnecting power. The reset circuit uses a pull-up resistor and a 0.1 µF capacitor for reliable signal conditioning.
VCC
RX0
Controller
Temperature Sensor
Photoresistor measures ambient light levels. Connected in a voltage divider to provide an analog output.Values below the set threshold indicate insufficient light, triggering a purple LED alert and tracking sunlight accumulation for the plant.
The DHT11 sensor measures air temperature It sends digital readings to pin 2, which the Arduino converts to Fahrenheit. Readings outside the user-defined temperature range trigger red (too hot) or blue (too cold) LED alerts.
Mounting Holes
Photoresistor
Soil Moisture Sensor
The potentiometer adjusts the LCD's contrast for clear visibility.
Reset Button for Smart Plant Monitor
USB Power Bank
RGB LED
Column 1
The keypad allows the user to input plant monitoring settings, such as soil moisture minimums, temperature ranges, light thresholds, monitoring intervals, and sunlight goals. It supports numeric input, backspace, clear, and enter commands.
Key Membrane Switch
The system is powered by a USB Power Bank. This provides stable power to the Arduino, sensors, RGB LED, keypad, and LCD. A switch can be added to turn the system on and off.
DTR
Row 0
Column 3
Reset Button, duplicate for gen purpose button
Column 2
This pushbutton allows the user to reset the system by holding it for 5 seconds. When activated, it restarts the clears accumulated readings.
Row 2
Row 3
This sensor measures the water content in the soil. It outputs an analog voltage proportional to the moisture level. If the soil moisture falls below the user-defined threshold, the system flags the soil as too dry and triggers a yellow LED alert.
Row 1
TXO
A serial connector is also included for programming and debugging through a USB-to-serial adapter, allowing the microcontroller to communicate with a computer for data monitoring or firmware uploads.
CTS
Column 0

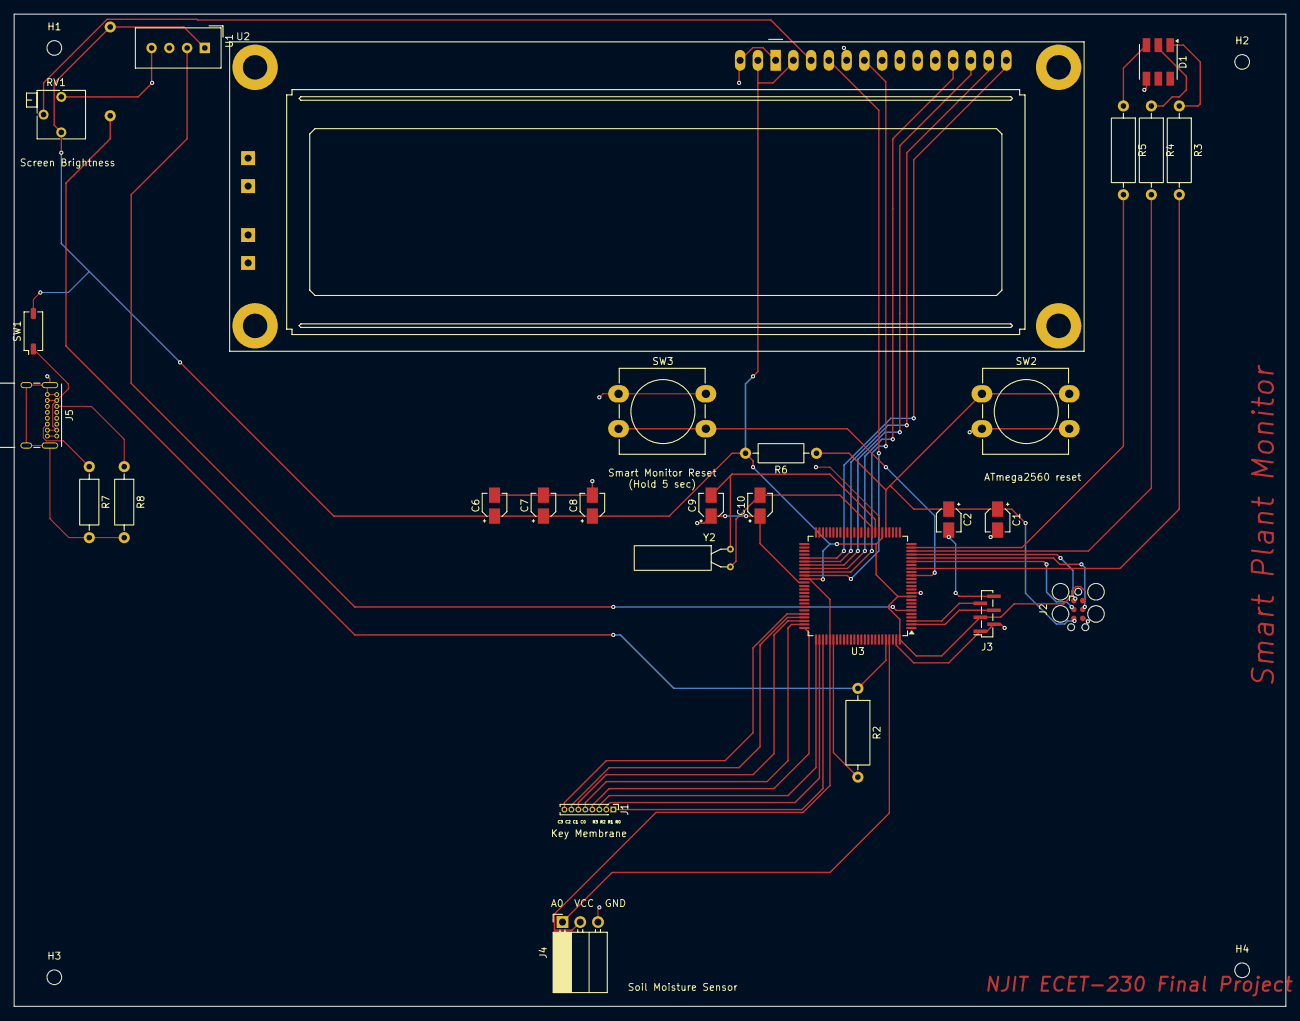
[picture p47: board ECET230 Smart Plant Monitor.kicad_pcb from above]

Board: 2 copper layers, 182.0 x 142.0 mm, 33 parts (1 on the bottom side), 39 nets.
