hgh-29/Smart-Plant-Monitor/(commit log)

2025-12-18 Add installation guide for KiCad
    Added installation instructions for KiCad on Windows and macOS.
2025-12-18 Add download link for KiCad installation
    Updated installation instructions for KiCad with a download link.
2025-12-18 Add instructions to download Arduino IDE
